WouterThys/RCMeasure/measured1.ods

 |  |  | count max | count min
ADSCALE | 1023 |  | 767,2500 | 664.95
ADREF | 3.3
Range | R | I |  |  |  | Range | R | I
1 | 3.90E+06 | 5.50E-07 |  |  |  | 2 | 3.90E+05 | 5.50E-06
I | Delay | Count | V | C | Delay/Count | I | Delay | Count | V | C
0 | 300 | 9 | 0,0290 | 5.68E-09 | 33,33 | 0 | 300 | 71 | 0,2290 | 720.42E-12 | 4,23
1 | 320 | 9 | 0,0290 | 6.06E-09 | 35,56 | 1 | 320 | 79 | 0,2548 | 690.63E-12 | 4,05
2 | 340 | 10 | 0,0323 | 5.80E-09 | 34,00 | 2 | 340 | 96 | 0,3097 | 603.85E-12 | 3,54
3 | 360 | 10 | 0,0323 | 6.14E-09 | 36,00 | 3 | 360 | 96 | 0,3097 | 639.38E-12 | 3,75
4 | 380 | 11 | 0,0355 | 5.89E-09 | 34,55 | 4 | 380 | 96 | 0,3097 | 674.90E-12 | 3,96
5 | 400 | 12 | 0,0387 | 5.68E-09 | 33,33 | 5 | 400 | 96 | 0,3097 | 710.42E-12 | 4,17
6 | 420 | 12 | 0,0387 | 5.97E-09 | 35,00 | 6 | 420 | 96 | 0,3097 | 745.94E-12 | 4,38
7 | 440 | 12 | 0,0387 | 6.25E-09 | 36,67 | 7 | 440 | 99 | 0,3194 | 757.78E-12 | 4,44
8 | 460 | 12 | 0,0387 | 6.54E-09 | 38,33 | 8 | 460 | 103 | 0,3323 | 761.46E-12 | 4,47
9 | 480 | 12 | 0,0387 | 6.82E-09 | 40,00 | 9 | 480 | 111 | 0,3581 | 737.30E-12 | 4,32
10 | 500 | 12 | 0,0387 | 7.10E-09 | 41,67 | 10 | 500 | 112 | 0,3613 | 761.16E-12 | 4,46
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
