WouterThys/RCMeasure/pcb/rcmeasure.kicad_pcb

## KiCad design pcb/rcmeasure.kicad_pcb (2018-02-04)

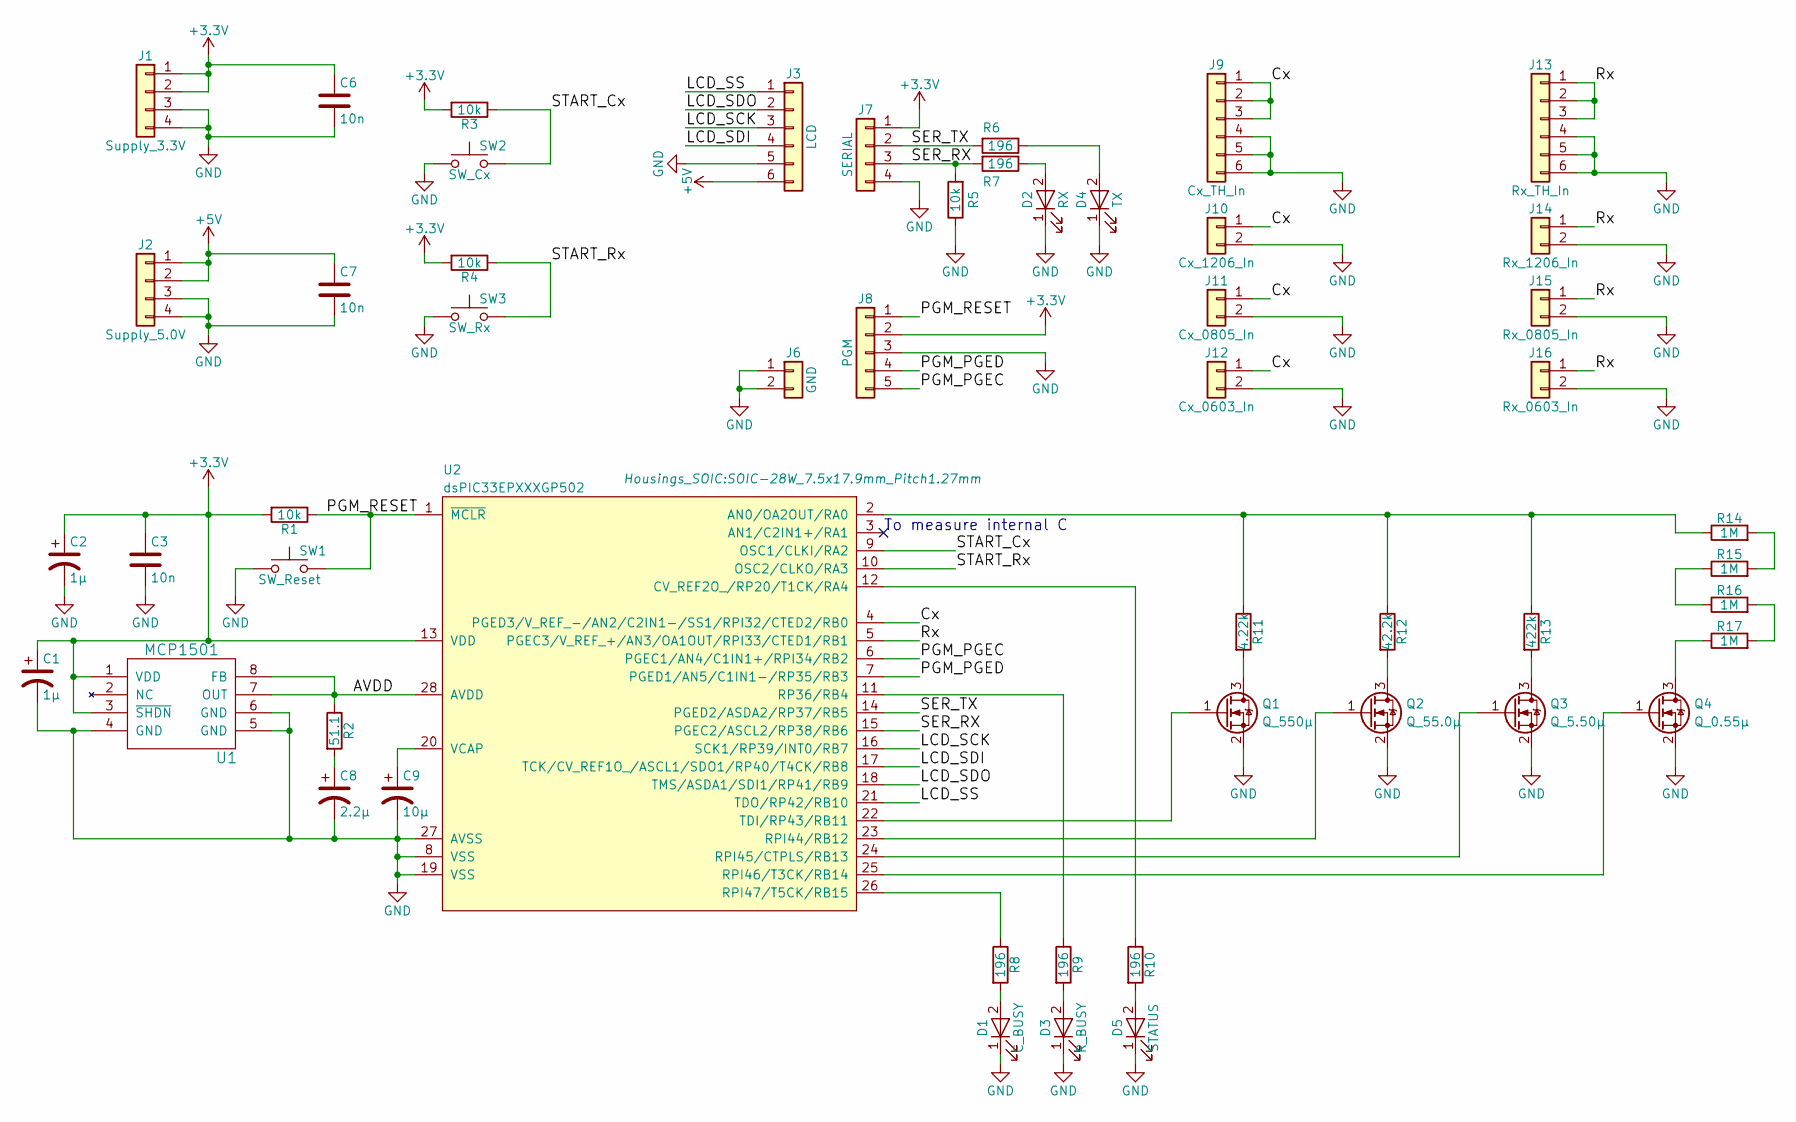
[picture p1: schematic rcmeasure.sch]

Parts:
C1, C2: 1µ; C_0603_HandSoldering
C3, C6, C7: 10n; C_0603_HandSoldering
C8: 2.2µ; CP_Tantalum_Case-A_EIA-3216-18_Hand
C9: 10µ; CP_Tantalum_Case-A_EIA-3216-18_Hand
D1: C_BUSY; LED_0603_HandSoldering
D2: RX; LED_0603_HandSoldering
D3: R_BUSY; LED_0603_HandSoldering
D4: TX; LED_0603_HandSoldering
D5: STATUS; LED_0603_HandSoldering
J1: Supply_3.3V; Molex_PicoBlade_53047-0410_04x1.25mm_Straight
J2: Supply_5.0V; Molex_PicoBlade_53047-0410_04x1.25mm_Straight
J3: LCD; Molex_PicoBlade_53047-0610_06x1.25mm_Straight
J6: GND; Pin_Header_Straight_1x02_Pitch2.54mm
J7: SERIAL; Molex_PicoBlade_53047-0410_04x1.25mm_Straight
J8: PGM; Pin_Header_Angled_1x05_Pitch2.54mm
J9: Cx_TH_In; Pin_Header_Straight_1x06_Pitch2.54mm
J10: Cx_1206_In; CP_Tantalum_Case-A_EIA-3216-18_Hand
J11: Cx_0805_In; C_0805_HandSoldering
J12: Cx_0603_In; C_0603_HandSoldering
J13: Rx_TH_In; Pin_Header_Straight_1x06_Pitch2.54mm
J14: Rx_1206_In; R_1206_HandSoldering
J15: Rx_0805_In; R_0805_HandSoldering
J16: Rx_0603_In; R_0603_HandSoldering
Q1: Q_550µ; SOT-23_Handsoldering
Q2: Q_55.0µ; SOT-23_Handsoldering
Q3: Q_5.50µ; SOT-23_Handsoldering
Q4: Q_0.55µ; SOT-23_Handsoldering
R1, R3, R4, R5: 10k; R_0603_HandSoldering
R2: 51.1; R_0603_HandSoldering
R6, R7, R8, R9, R10: 196; R_0603_HandSoldering
R11: 4.22k; R_0603_HandSoldering
R12: 42.2k; R_0603_HandSoldering
R13: 422k; R_0603_HandSoldering
R14, R15, R16, R17: 1M; R_0603_HandSoldering
SW1: SW_Reset; SW_SPST_B3S-1000
SW2: SW_Cx; SW_SPST_B3S-1000
SW3: SW_Rx; SW_SPST_B3S-1000
U1: MCP1501; SOIC-8_3.9x4.9mm_Pitch1.27mm
U2: dsPIC33EPXXXGP502; SOIC-28W_7.5x17.9mm_Pitch1.27mm

Connections:
+3V3: C1.1, C2.1, C3.1, C6.1, J1.1, J1.2, J7.1, J8.2, R1.2, R3.2, R4.2, U1.1 (VDD), U1.3 (~SHDN), U2.13 (VDD)
+5V: C7.1, J2.1, J2.2, J3.6
/AVDD: R2.1, U1.7 (OUT), U1.8 (FB), U2.28 (AVDD)
/Cx: J9.1, J9.2, J9.3, J10.1, J11.1, J12.1, U2.4 (PGED3/V_REF_-/AN2/C2IN1-/SS1/RPI32/CTED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)
/LCD_SCK: J3.3, U2.16 (SCK1/RP39/INT0/RB7)
/LCD_SDI: J3.4, U2.17 (TCK/CV_REF1O_/ASCL1/SDO1/RP40/T4CK/RB8)
/LCD_SDO: J3.2, U2.18 (TMS/ASDA1/SDI1/RP41/RB9)
/LCD_SS: J3.1, U2.21 (TDO/RP42/RB10)
/PGM_PGEC: J8.5, U2.6 (PGEC1/AN4/C1IN1+/RPI34/RB2)
/PGM_PGED: J8.4, U2.7 (PGED1/AN5/C1IN1-/RP35/RB3)
/PGM_RESET: J8.1, R1.1, SW1.2, U2.1 (~MCLR)
/Rx: J13.1, J13.2, J13.3, J14.1, J15.1, J16.1, U2.5 (PGEC3/V_REF_+/AN3/OA1OUT/RPI33/CTED1/RB1)
/SER_RX: J7.3, R5.2, R7.2, U2.15 (PGEC2/ASCL2/RP38/RB6)
/SER_TX: J7.2, R6.2, U2.14 (PGED2/ASDA2/RP37/RB5)
/START_Cx: R3.1, SW2.2, U2.9 (OSC1/CLKI/RA2)
/START_Rx: R4.1, SW3.2, U2.10 (OSC2/CLKO/RA3)
GND: C1.2, C2.2, C3.2, C6.2, C7.2, C8.2, C9.2, D1.1 (K), D2.1 (K), D3.1 (K), D4.1 (K), D5.1 (K), J1.3, J1.4, J2.3, J2.4, J3.5, J6.1, J6.2, J7.4, J8.3, J9.4, J9.5, J9.6, J10.2, J11.2, J12.2, J13.4, J13.5, J13.6, J14.2, J15.2, J16.2, Q1.2 (S), Q2.2 (S), Q3.2 (S), Q4.2 (S), R5.1, SW1.1, SW2.1, SW3.1, U1.4 (GND), U1.5 (GND), U1.6 (GND), U2.8 (VSS), U2.19 (VSS), U2.27 (AVSS)
unnamed: C8.1, R2.2
unnamed: C9.1, U2.20 (VCAP)
unnamed: D1.2 (A), R8.2
unnamed: D2.2 (A), R7.1
unnamed: D3.2 (A), R9.2
unnamed: D4.2 (A), R6.1
unnamed: D5.2 (A), R10.2
unnamed: Q1.1 (G), U2.22 (TDI/RP43/RB11)
unnamed: Q1.3 (D), R11.2
unnamed: Q2.1 (G), U2.23 (RPI44/RB12)
unnamed: Q2.3 (D), R12.2
unnamed: Q3.1 (G), U2.24 (RPI45/CTPLS/RB13)
unnamed: Q3.3 (D), R13.2
unnamed: Q4.1 (G), U2.25 (RPI46/T3CK/RB14)
unnamed: Q4.3 (D), R17.1
unnamed: R8.1, U2.26 (RPI47/T5CK/RB15)
unnamed: R9.1, U2.11 (RP36/RB4)
unnamed: R10.1, U2.12 (CV_REF2O_/RP20/T1CK/RA4)
unnamed: R11.1, R12.1, R13.1, R14.1, U2.2 (AN0/OA2OUT/RA0)
unnamed: R14.2, R15.2
unnamed: R15.1, R16.1
unnamed: R16.2, R17.2

Notes on the sheet:
To measure internal C

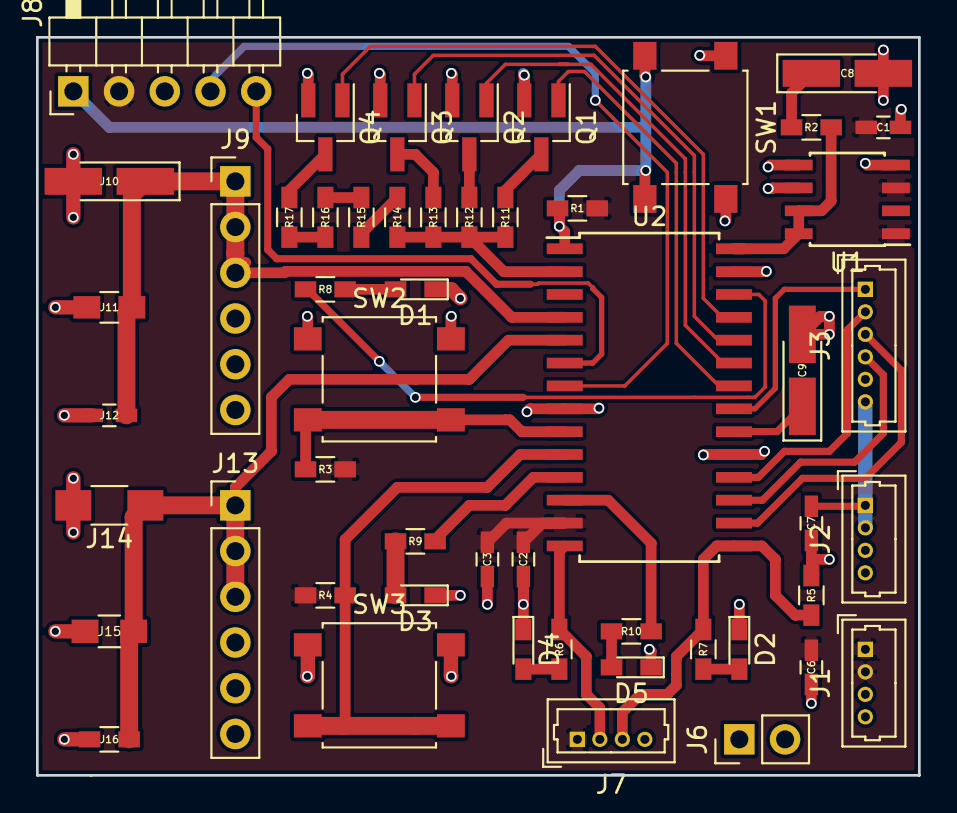
[picture p2: board rcmeasure.kicad_pcb from above]

Board: 2 copper layers, 49.0 x 41.0 mm, 52 parts (0 on the bottom side), 39 nets.
