WouterThys/RCMeasure/(commit log)

2018-01-25 created current iteration test
2018-02-04 create pcb and clean up c code
    [measured1.ods, rcmeasure.kicad_pcb, rcmeasure.sch]
2018-02-04 resistance measurement
